micahflock/Firewatch/docs/hardware.md

# Hardware: survey, recommendation, parts list, wiring

## What the job actually needs

- **Wi-Fi.** The controller has to talk to the Roku (ECP) and serve a small web page. This rules out plain MCUs.
- **Glitch-free LED timing while Wi-Fi is busy.** The LED bitstream should come from DMA hardware, not CPU bit-banging.
- **Good low-brightness color.** A fire glow in a dark room lives in the bottom 10–30% of an LED's range, where 8-bit channels show visible steps.
- **Warm color quality.** The light falls on brick, the mantel, and the room, so it should look like firelight, not like "RGB orange".
- **About 1.5 m of strip.** It runs up the left side, across the top and down the right side of the TV's back, about 20 mm in from the edges (the TV is 731 × 437 mm), with none along the bottom. At 75 LEDs (3 dark lead-in + 72 lit), voltage drop is a non-issue at 5 V, and feeding power at the start alone is enough.

The light doesn't need to be dotless or high-density. The strip faces the firebox walls, not the viewer, so all you see is diffuse reflection.

## Controller options

| Option | Strengths | Weaknesses | Verdict |
|---|---|---|---|
| **QuinLED Dig-Uno v3 (classic ESP32 on a LED carrier board)** | The same classic ESP32 as below, plus a level shifter, 10 A fuse, bulk capacitors, screw terminals, USB-C and a 5–24 V input on one board. No soldering, and no parts packs to buy. | $27.50–37.50 + shipping from a small shop; needs its own mount (provided) | **Chosen** |
| ESP32 dev board (classic, WROOM-32E DevKitC) + DIY perfboard | Same chip and firmware; cheapest *if you already have a parts bin* (≈$16 in parts) | You solder a level shifter, fuse, terminals and diode yourself; buying all those parts in packs from scratch costs more than a Dig-Uno | Good if you have parts on hand |
| ESP32-S3 | Native USB, more RAM, PSRAM variants | No benefit for 75 LEDs; the parallel-I2S LED drivers are younger on the S3 | Fine, not better |
| ESP32-C3 / C6 | Tiny and cheap | Single core shared with Wi-Fi; fewer RMT channels; C6 LED support is still young | Workable, not ideal |
| Raspberry Pi Pico 2 W | PIO gives perfect LED timing | HTTP, mDNS and OTA are less polished under Arduino; no real advantage here | No |
| Other ready-made ESP32 LED boxes (Gledopto, Athom "WLED" controllers) | Cased, cheap | Pinouts vary by vendor, less documented; not all expose USB for flashing | Workable; set `LED_PIN` |
| Raspberry Pi Zero 2 W | Could also drive a screen | Overkill, SD card wear, 30 s boot, no real-time I/O | No |

## LED strip options

| Strip | Supply | Color | Strengths | Weaknesses |
|---|---|---|---|---|
| WS2812B | 5 V | RGB, 8-bit | Cheap and everywhere | "Warm" is mixed from narrow red and green peaks, which looks synthetic on brick and wood. Steps at low brightness. |
| **SK6812 RGBW, warm-white (≈3000 K)** | 5 V | RGB + W, 8-bit | The white die is phosphor-converted and broad-spectrum, so the glow's body looks like real warm light. RGB adds the red and orange flicker on top. Same one-wire protocol and libraries as WS2812B. Better lumens per watt for warm tones. | Slightly pricier. W is also 8-bit (the firmware dithers). |
| WS2815 | 12 V | RGB | Backup data line, lower current | Needs a buck converter for the ESP32; RGB only; 12 V is pointless at 1.5 m |
| APA102 / SK9822 | 5 V | RGB + 5-bit global | Fast PWM; the 5-bit global brightness helps low end | Four wires, pricier, still RGB-only color |
| HD108 | 5 V | 16-bit RGB | Excellent dimming | Niche, expensive, young library support |
| COB/FCOB addressable (WS2811, 12/24 V) | 12/24 V | RGB, coarse segments | Dotless | Dots are invisible here anyway (the light is reflected); coarse addressing |

## Recommendation

**QuinLED Dig-Uno v3 (pre-assembled, with QuinLED-ESP32) + SK6812 RGBW warm-white, 5 V, 60 LED/m, 10 mm, IP30 + a 5 V 3–4 A supply**, in a printed enclosure screwed to the TV's VESA holes. The wiring uses the Dig-Uno's screw terminals and a few soldered joints, so the only wire you buy is one roll of 22 AWG 3-conductor.

Why this combination:
- **RGBW warm-white is the biggest quality lever.** Real firelight is broadband, and a phosphor white die gets much closer to it than any RGB mix. On the fitted strip, though, the white die outshines the red one, and a glow built on it read as pale peach-white on the brick. The fire palette ([`fire.cpp`](../firmware/lib/firecore/src/fire.cpp)) therefore builds the glow from red and green, and adds W only to flares.
- **Low-brightness steps are handled in software.** Colors are computed in 16-bit and temporally dithered to 8-bit at 120 fps. That's cheaper and simpler than moving to 16-bit or SPI LEDs.
- **The Dig-Uno is a classic ESP32** (the lowest-risk platform for Wi-Fi plus LEDs) with the support circuitry already built: level shifter, fuse, capacitors, terminals. If you're buying everything from scratch, it costs less than the packs of parts you'd need to build that yourself, and it removes the usual failure points: grounding, the level shifter, and power wiring.
- **60 LED/m over 30/m:** more headroom and a smoother glow for a few dollars more.
- **IP30 (uncoated):** silicone-coated strips trap heat, yellow over time, and hold adhesive worse. There's no moisture in a firebox that isn't burning.

**Dig-Uno facts this design relies on** (from QuinLED's [pinout guide](https://quinled.info/quinled-dig-uno-pinout-guide/) and [dimension drawing](https://quinled.info/2020/08/02/quinled-dig-uno-board-dimensions/)):

| | |
|---|---|
| PCB | 48.52 × 39.37 mm, 4× M2 holes on a 43.27 × 34.02 mm rectangle, 26 mm from the PCB underside to the tallest part with the ESP32 fitted (measured; the enclosure leaves 2 mm above that) |
| LED data | **LED1 terminal = GPIO16** (`LED_PIN`). A jumper can move it to GPIO1; leave it on GPIO16, because GPIO1 is the serial TX pin. |
| Button | GPIO0 (`BUTTON_PIN`) |
| Spare GPIO | Q1 = GPIO15, Q2 = GPIO12 on the Q1/Q2 header (5V, GND, 3V3, Q2, Q1). Q3/Q4 = GPIO2/32. |
| Power | 5–24 V in, 10 A ATO fuse fitted, 15 A continuous |

## Shopping list (from scratch)

This keeps the number of separate purchases small. It assumes you already have a soldering iron, solder, a multimeter, a wire stripper and flush cutters. Rough 2026 US prices; where a part only comes in packs, the price is for the pack.

| # | Part | Qty used | What to buy | ≈ $ |
|---|---|---|---|---|
| 1 | **QuinLED Dig-Uno v3, pre-assembled, with QuinLED-ESP32, onboard antenna** | 1 | [quinled.info](https://quinled.info/pre-assembled-quinled-dig-uno/) or a listed distributor | 27.50–37.50 + shipping |
| 2 | **SK6812 RGBW, warm white (≈3000 K), 5 V, 60 LED/m, 10 mm, IP30** (e.g. BTF-LIGHTING) | 1.25 m (75 LEDs) | 2 m reel, leaving spare LEDs for mistakes | 20 |
| 3 | **5 V DC supply, 3–4 A, 5.5 × 2.1 mm center-positive plug**: Mean Well GST25A05-P1J (4 A, the most proven for 24/7 use) or BTF-LIGHTING 5 V 3 A adapter | 1 | Check the unit carries a UL/ETL mark. Some BTF adapters include a female barrel-to-screw-terminal adapter, which replaces item 4. | 13–15 |
| 4 | Female 5.5 × 2.1 mm DC barrel jack pigtail (pre-wired, ~15–20 cm leads) | 1 | Pack of 5–10. Its leads go into the Dig-Uno's power input, so the supply unplugs at the jack. | 7 |
| 5 | 22 AWG 3-conductor LED wire | ~1 m | 5 m roll. It's used for every connection: the run to the strip start and the two corner bridges. | 8 |
| 6 | Heat-shrink tubing | a few pieces | Small assortment | 7 |
| 7 | M4 × 12 mm pan-head screws | 4 | Small pack (VESA) | 6 |
| 8 | M2 × 8 mm self-tapping pan-head screws | 8 | Pack. They hold the board (4) and the lid (4). | 7 |
| 9 | 3M VHB tape, 12 mm (e.g. 5952) | ~0.5 m | Roll | 12 |
| 10 | Cable ties (≤ 3.6 mm wide) | a few | Pack | 4 |
| 11 | Printed parts: `firewatch_base.stl`, `firewatch_lid.stl`, 14 × `strip_clip_base_10mm.stl` + 14 × `strip_clip_cap_10mm.stl` | | PETG, about 80 g | — |
| | **Total** | | | **≈ $115–125 + Dig-Uno shipping** |

**What got cut, and why:**
- **Wago connectors:** solder joints under heat-shrink do the same job.
- **18 AWG wire:** at under 3 A over less than a metre, 22 AWG drops under 0.2 V.
- **Washers:** the M4 pan heads are wider than the 4.5 mm slots.
- **Adhesive cable clips:** leftover VHB holds the wire runs down.

**Optional IR blaster.** Only needed if you can't use Fast TV start; see [feasibility](feasibility.md#3-ir-blaster-fallback).

| Part | Qty | Notes |
|---|---|---|
| 940 nm IR LED (e.g. Vishay TSAL6200) | 1 | Aim it at the IR window on the TV's front bottom edge |
| PN2222A NPN transistor | 1 | |
| 1 kΩ (base) and 33 Ω (LED) resistors | 1 each | About 100 mA pulses from 5 V |
| Female-female Dupont jumper wires | 3 | Cut one end off. They plug onto the Q1/Q2 header, and the spare 22 AWG wire carries the run to the LED. |

## Wiring

```
 GST25A05 ──plug──► female barrel pigtail ──► Dig-Uno power input  (+ / −)
                    (cable-tied to the anchor beside the box)

 Dig-Uno LED output terminal
     5V   ─── 22AWG ──┐                  ┌──►  strip START  +5V pad
     LED1 ─── 22AWG ──┼─ JST-SM 3-pin ───┼──►  strip START  DIN pad
                      │ (unplug here)    │     (GPIO16, level-shifted)
     LED2     (unused)
     GND  ─── 22AWG ──┘                  └──►  strip START  GND pad

 Strip START = bottom of the left side (front view); strip END = bottom of the right side.

 Optional IR (Q1/Q2 header):  Q1 (GPIO15) ─[1k]─ PN2222 base; emitter → GND;
     collector → IR LED cathode; IR LED anode ─[33Ω]─ 5V.   Then set IR_LED_PIN 15.
```

Notes:
- **Supply polarity.** Pigtail lead colors aren't guaranteed. Plug the supply in, check which lead is + with a multimeter (leads apart), and unplug it again before landing them in the terminal.
- **Strain relief.** Cable-tie the pigtail's jack to one of the power-side anchors, so unplugging the supply pulls on the anchor, not the screw terminal.
- **One feed is enough.** QuinLED's guidance is that a 5 V strip of up to about 90 LEDs can be fed from one end, and this one is 75, drawing about 1–1.6 A. The far end is at the opposite bottom corner, so skipping a second feed also saves a wire across the TV. Don't tin the wire ends that go into the screw terminals; tinned wire loosens over time.
- **Strip connector.** BTF reels come with a JST-SM 3-pin plug on each end, and the two plugs mate. Keep the plug on the strip's **start** end (data arrows pointing away from it). Cut the other plug off the reel's far end with its pigtail, extend its three wires with the 22 AWG run (solder + heat-shrink), and land them in the Dig-Uno's LED output. The strip then unplugs from the controller at the connector. Match wires by what they connect to, not by color: follow each pigtail wire to the `+5V`, `Din` and `GND` pads, or check with a multimeter. Trim or heat-shrink any loose extra power leads, and cover the far end's bare pads.
- **Common ground** is automatic: everything shares the supply's GND at the Dig-Uno.
- **Don't cut strip power when "off".** An unpowered strip gets back-powered through its data line. Idle draw is about 1 mA per LED (≈0.6 W) plus about 0.5 W for the ESP32.
- **Flash over USB-C with the supply unplugged.** After the first flash, updates go over Wi-Fi.

## Power budget

| | Current (5 V) |
|---|---|
| Theoretical max: 72 lit LEDs × 4 channels × ~15 mA | 4.3 A (never reached) |
| Firmware cap (`POWER_BUDGET_MA`), including the ESP32 | 2.5 A |
| Fire at 30% brightness (default), firmware estimate over 100 s, all-in | avg 0.6 A, peak 0.7 A |
| Fire at 100% brightness | avg 1.4 A, peak 1.6 A |
| Off (ESP32 on Wi-Fi + strip idle) | ≈ 0.2 A (≈ 1.1 W) |

The web page shows the firmware's live current estimate (`ledCurrentMa`). The Dig-Uno's 10 A fuse and 15 A rating leave plenty of margin, and a 3 A supply still has about 1.4 A to spare even at full brightness.

## Mounting

The back of the TV with Firewatch fitted

*As built, seen from behind: the enclosure on the VESA holes and the strip on clips up both sides and across the top. The supply plugs in at the barrel jack on the left, and the strip at the JST plug on the right, near where it starts.*

Assembly

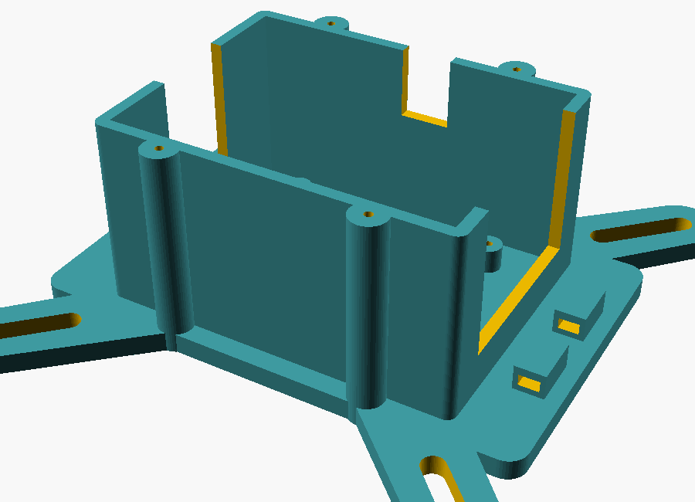
[picture p9: docs/img/base.png]
Base
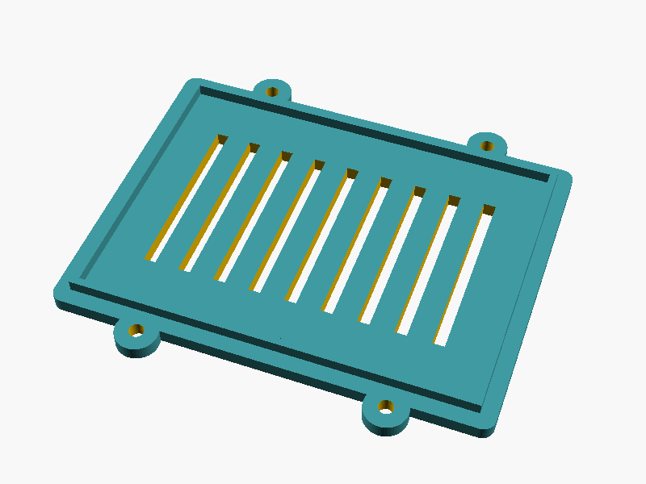
[picture p10: docs/img/lid.png]
Lid
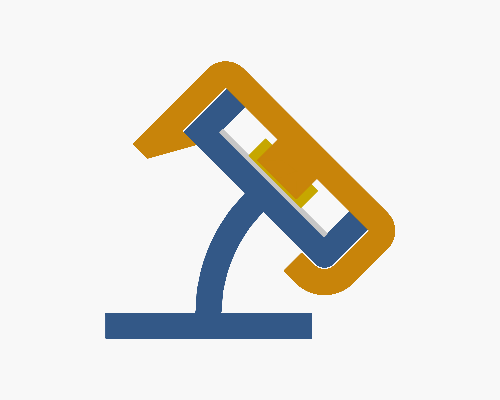
[picture p11: docs/img/clip.png]
Strip clip, end view, with the strip on the seat under the cap
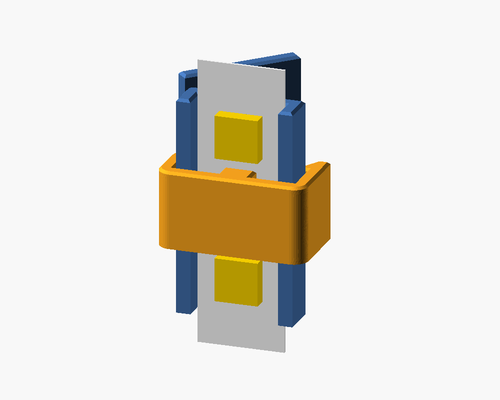
[picture p12: docs/img/clip_3d.png]
Strip clip with the cap between two LEDs
   

Sources: [`hardware/mount/firewatch_mount.scad`](../hardware/mount/firewatch_mount.scad) for the base and lid (parametric OpenSCAD, with the Dig-Uno dimensions from QuinLED's drawing), and [`hardware/mount/strip_clip_10mm.step`](../hardware/mount/strip_clip_10mm.step) for the strip clip (designed in Fusion 360; the STEP opens in any CAD program for changes). STLs are in [`hardware/mount/stl/`](../hardware/mount/stl).

| File | What | Print |
|---|---|---|
| `firewatch_base.stl` | X-shaped VESA plate + Dig-Uno enclosure. The diagonal slots fit **both 75 × 75 and 100 × 100** (the 32S335 is 100 × 100, M4). Four M2 standoffs on the Dig-Uno's hole pattern. A wide window on the power end for the barrel-jack pigtail's leads **and USB-C access**, a notch on the LED end for the strip wiring, a small notch for the optional IR lead, and three cable-tie anchors. | Flat side down, 20% infill, no supports. Load-bearing walls are 1.67 mm, locating walls (the lid lip) 0.86 mm, and the plate is 2 mm (`strong_wall`, `light_wall`, `plate_t` in the source). |
| `firewatch_base_M6.stl` | Same, with M6 clearance slots for other TVs | |
| `firewatch_lid.stl` | Vented lid with a locating lip; four M2 screws | Flat (outer) face down, no supports |
| `strip_clip_base_10mm.stl` + `strip_clip_cap_10mm.stl` | Two-part 45° strip clip for 10 mm strip. The 25 mm base sticks to the TV on a thin sole, and a curved arm carries a seat that holds the strip facing outward and backward toward the firebox walls. The strip lies in a shallow channel on the seat, so it never has to bend across its width. The 9 mm cap wraps over the seat **between two LEDs** and holds the strip down. | Both **chamfered end face down** (as exported), no supports, so elephant's foot from the first layers lands in the chamfer instead of fouling the snap fit. 14 of each. |

The Dig-Uno fits with its power terminal and USB-C toward the window end and its LED output toward the notch end. The standoffs only fit that way round, or rotated 180°.

**Installing the base:** use M4 × 12 pan-head screws through the 2 mm plate, which gives about 10 mm of thread engagement. Turn each screw in by hand first: if one stops before the head seats, it's bottoming out in the insert, so use an M4 × 10 (or add a washer) rather than forcing it. The slots near the 75 mm positions sit close to the box walls, so use a screwdriver with a shaft of at least 75 mm. The 100 mm positions have plenty of clearance.

**Wi-Fi:** the board sits between the TV's metal chassis and the brick. Check the signal (`rssi` on the status page, in dBm). If it's worse than about −75, QuinLED sells an external-antenna version of the ESP32 board, and its lead can leave through the power window.

**Strip placement:** put clips about 20 mm in from the TV's outer edge, up the left side, across the top and down the right side (none along the bottom). Space them every ~15 cm, plus one on each side of the two top corners (about 12–14 in total), with the seat facing outward. **At the two top corners, bend the strip around in one piece** (the as-built choice). It saves four solder joints, at the cost of some stress on the flexible PCB and roughly one LED of length per corner. Alternatively, cut at the copper cut marks and bridge the three pads with short lengths of the 22 AWG 3-conductor wire, soldered on the bench before fitting. The first 3 LEDs of the strip serve as a dark lead-in that carries the plug end out to where the left run starts (`LED_LEAD_IN`). Clean the TV back with isopropyl alcohol before applying the VHB, and press for 30 s. If your per-side LED counts differ from 17/38/17, put them in `kLedLayout`.

A side run of the strip on its clips

*A side run: each clip base holds the strip at 45°, facing outward, with a cap snapped on between two LEDs.*
