micahflock/Firewatch/hardware/mount/stl/strip_clip_cap_10mm.stl

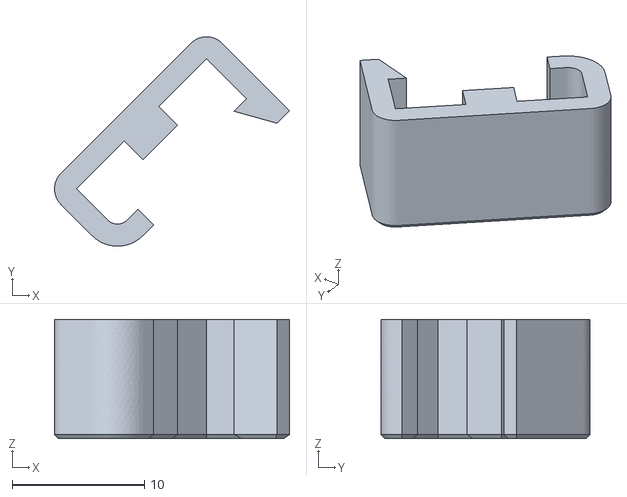
[picture p13: CAD file, 2026-10-17]
hardware/mount/stl/strip_clip_cap_10mm.stl
17.8 x 15.8 x 9.00
