micahflock/Firewatch/hardware/mount/strip_clip_10mm.step

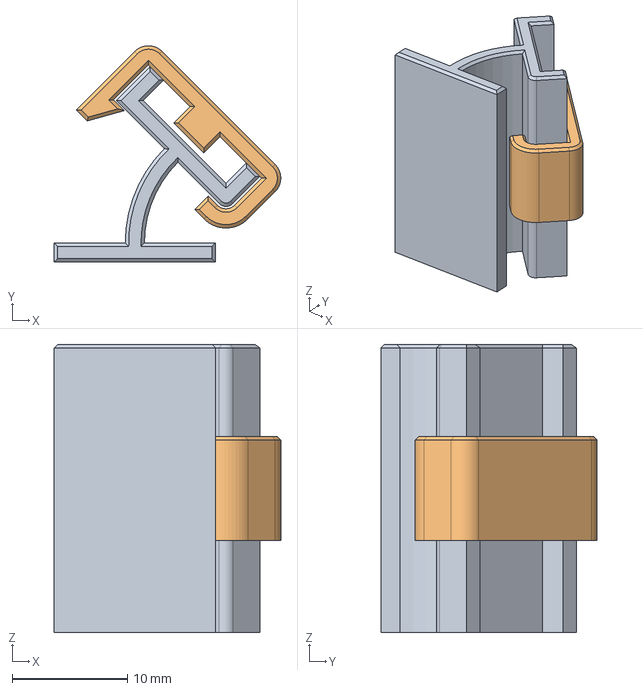
[picture p14: CAD file, 2026-10-16]
hardware/mount/strip_clip_10mm.step
19.7 x 18.8 x 25.0 mm
