micahflock/Firewatch/hardware/mount/stl/strip_clip_base_10mm.stl

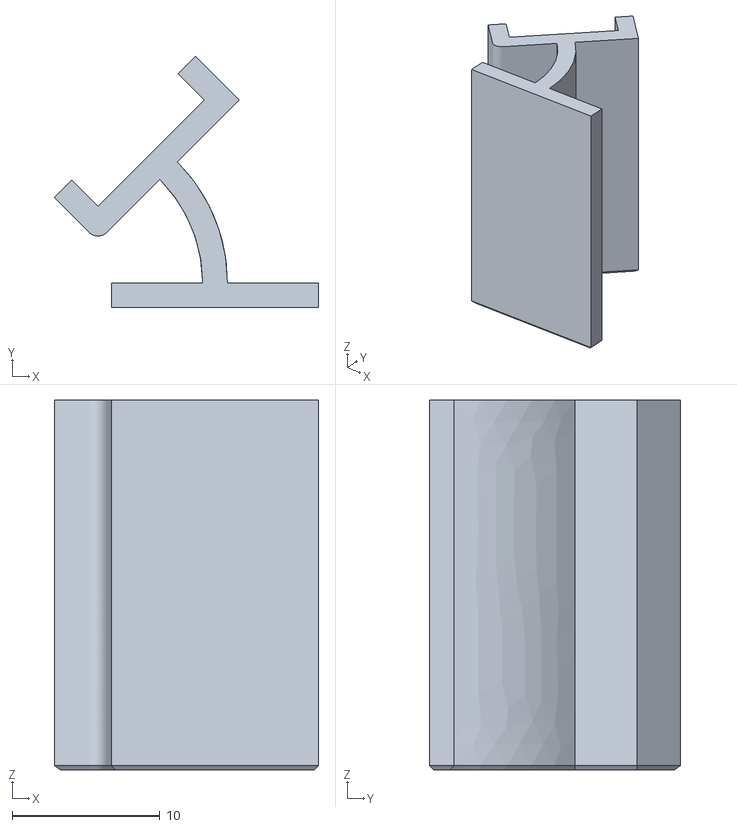
[picture p15: CAD file, 2026-10-17]
hardware/mount/stl/strip_clip_base_10mm.stl
17.9 x 17.0 x 25.0
