micahflock/Firewatch/hardware/mount/stl/firewatch_lid.stl

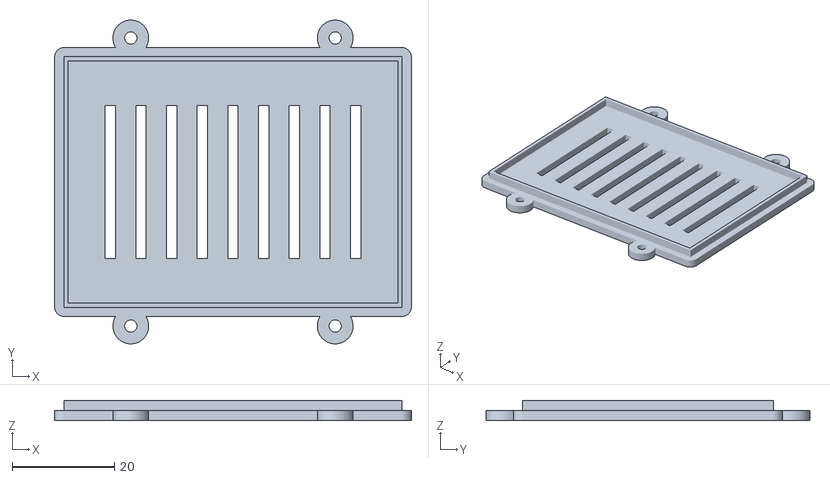
[picture p16: CAD file, 2026-10-08]
hardware/mount/stl/firewatch_lid.stl
69.9 x 63.4 x 3.99
