micahflock/Firewatch/hardware/mount/stl/firewatch_base.stl

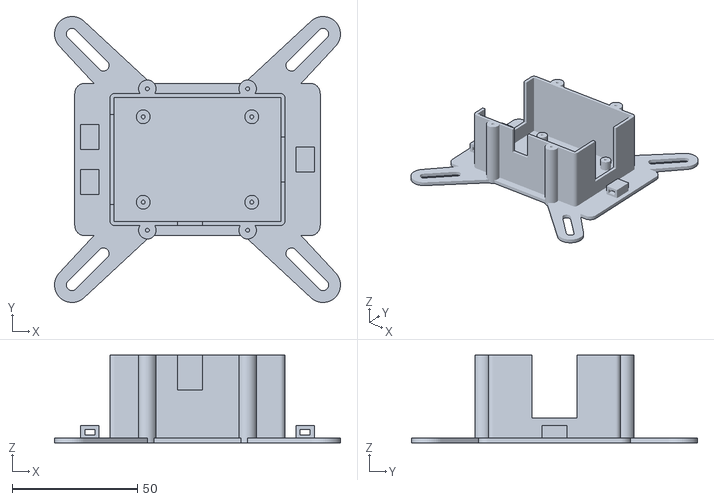
[picture p17: CAD file, 2026-10-08]
hardware/mount/stl/firewatch_base.stl
114.0 x 114.0 x 35.0
