micahflock/Firewatch/(list of files, cad)

Other CAD files:
hardware/mount/stl/firewatch_base_M6.stl
