micahflock/Firewatch/firmware/src/main.cpp

// Firewatch: fire-glow LEDs around a Roku TV, started and stopped together with the TV.
//
// Core 1 (Arduino loop): fire animation -> dithering -> LEDs at TARGET_FPS, plus button/OTA.
// Core 0: "net" task polls the TV and runs the Scene state machine; "web" task serves HTTP;
// HomeSpan's task serves Apple Home and owns Wi-Fi and mDNS. The BLE host task delivers
// lighter frames.
// The only state crossing tasks is a command queue, a few atomics, mutex-guarded status and
// the mutex-guarded fire tuning.

#include <Arduino.h>
#include <ArduinoOTA.h>
#include <ESPmDNS.h>
#include <Preferences.h>
#include <WebServer.h>
#include <WiFi.h>
#include <esp_random.h>
#include <esp_timer.h>

#include <atomic>
#include <mutex>

#include "config.h"
#include "fire.h"
#include "home_sync.h"
#include "homekit.h"
#include "ir.h"
#include "leds.h"
#include "lighter_rx.h"
#include "output.h"
#include "roku_client.h"
#include "scene.h"
#include "tuning.h"
#include "web_page.h"

#if __has_include("secrets.h")
#include "secrets.h"
#else
#warning "include/secrets.h missing - copy secrets.example.h and fill in your Wi-Fi details"
#include "secrets.example.h"
#endif
#ifndef HOMEKIT_SETUP_CODE
#define HOMEKIT_SETUP_CODE ""
#endif
#ifndef SKEUMO_LINK_KEY
#define SKEUMO_LINK_KEY ""
#endif
// HomeSpan halts the whole board at boot on a setup code it rejects.
static_assert(sizeof(HOMEKIT_SETUP_CODE) == 1 || fw::validSetupCode(HOMEKIT_SETUP_CODE),
              "HOMEKIT_SETUP_CODE in secrets.h must be 8 digits, not all the same digit, "
              "and not 12345678 or 87654321");

namespace {

QueueHandle_t commandQueue;
std::atomic<bool> lightsOn{false};
std::atomic<int> brightnessPct{DEFAULT_BRIGHTNESS};
std::atomic<float> currentMa{0};

struct Status {
  const char* state = "off";
  const char* tv = "unknown";
  String activeApp, host, model, event, error;
};
std::mutex statusMutex;
Status status;

RokuClient roku;
WebServer server(80);
Preferences prefs;
std::atomic<bool> wifiReady{false};

void setBrightness(int pct) {
  pct = constrain(pct, 0, 100);
  brightnessPct = pct;
  prefs.putUChar("bright", pct);
}

// Fire tuning from the web page. The web task edits `tuning` and bumps tuningVersion; the
// render loop copies it into the engine when it can take the lock without waiting. It is
// saved to flash once the sliders have been still for a moment, to spare the flash.
std::mutex tuningMutex;
fw::FireParams tuning;
std::atomic<uint32_t> tuningVersion{0};
uint32_t tuningChangedMs = 0;
bool tuningUnsaved = false;

String tuningPrefKey(const fw::Tunable& t) { return String("t_") + t.key; }

void loadTuning() {
  for (size_t i = 0; i < fw::kTunableCount; ++i) {
    const fw::Tunable& t = fw::kTunables[i];
    String k = tuningPrefKey(t);
    if (prefs.isKey(k.c_str())) fw::setTunable(tuning, t.key, prefs.getFloat(k.c_str()));
  }
}

// Only values that differ from the defaults are stored, so a later firmware's new defaults
// still reach the settings nobody has touched.
void saveTuning() {
  fw::FireParams p, d;
  {
    std::lock_guard<std::mutex> lock(tuningMutex);
    p = tuning;
  }
  for (size_t i = 0; i < fw::kTunableCount; ++i) {
    const fw::Tunable& t = fw::kTunables[i];
    String k = tuningPrefKey(t);
    if (p.*(t.field) == d.*(t.field)) {
      if (prefs.isKey(k.c_str())) prefs.remove(k.c_str());
    } else {
      prefs.putFloat(k.c_str(), p.*(t.field));
    }
  }
}

// Called once by HomeSpan when Wi-Fi first connects, after it has started mDNS as HOSTNAME.
void onWifiConnected() {
  Serial.printf("[wifi] connected %s\n", WiFi.localIP().toString().c_str());
  MDNS.addService("http", "tcp", 80);
  ArduinoOTA.setHostname(HOSTNAME);
  ArduinoOTA.setPassword(OTA_PASSWORD);
  ArduinoOTA.setMdnsEnabled(false);  // HomeSpan owns mDNS; register OTA with it instead
  ArduinoOTA.begin();
  MDNS.enableArduino(3232, true);
  wifiReady = true;
}

const char* stateName(fw::Scene::State s) {
  switch (s) {
    case fw::Scene::State::Off: return "off";
    case fw::Scene::State::Waking: return "waking TV";
    case fw::Scene::State::On: return "on";
  }
  return "?";
}

const char* tvName(fw::TvPower p) {
  switch (p) {
    case fw::TvPower::On: return "on";
    case fw::TvPower::Standby: return "standby";
    case fw::TvPower::Unreachable: return "unreachable";
  }
  return "?";
}

void execute(const fw::Actions& a) {
  if (a.powerOff) roku.powerOff();
  if (a.wake) roku.wake();
  if (a.launch) roku.launchFire();
}

// ---- network task: TV polling + scene policy ---------------------------------------
void netTask(void*) {
  fw::SceneTiming timing;
  timing.followTv = FOLLOW_TV;
  fw::Scene scene(timing);
  roku.begin(ROKU_HOST);
  uint32_t lastPoll = 0;
  fw::TvPower lastPower = fw::TvPower::Unreachable;

  for (;;) {
    fw::Command c;
    uint32_t interval = scene.state() == fw::Scene::State::Waking ? 1000 : POLL_INTERVAL_MS;
    uint32_t elapsed = millis() - lastPoll;
    TickType_t wait = pdMS_TO_TICKS(elapsed >= interval ? 0 : interval - elapsed);
    if (xQueueReceive(commandQueue, &c, wait) == pdTRUE) {
      fw::Actions a = scene.command(c, millis());
      lightsOn = scene.lightsOn();  // before the ECP calls, so the glow never waits on the TV
      execute(a);
    }
    if (WiFi.status() == WL_CONNECTED && millis() - lastPoll >= interval) {
      lastPoll = millis();
      fw::TvStatus s = roku.poll();
      lastPower = s.power;
      fw::Actions a = scene.observe(s, millis());
      lightsOn = scene.lightsOn();
      execute(a);
    }

    std::lock_guard<std::mutex> lock(statusMutex);
    status.state = stateName(scene.state());
    status.tv = tvName(lastPower);
    status.activeApp = roku.activeApp();
    status.host = roku.host();
    status.model = roku.model();
    status.event = scene.lastEvent();
    status.error = roku.lastError();
  }
}

// ---- Apple Home + lighter ----------------------------------------------------------------
bool lighterLinkOk = false;

void queueCommand(fw::Command c) { xQueueSend(commandQueue, &c, 0); }

void onLighter(const skeumo::link::Message& m) {
#if LIGHTER_DIRECT
  if (m.channel == LIGHTER_STRIKE_CHANNEL) queueCommand(fw::Command::On);
  if (m.channel == LIGHTER_SNUFF_CHANNEL) queueCommand(fw::Command::Off);
#endif
  homekit::lighterEvent(m);
}

// ---- web task ------------------------------------------------------------------------
void sendCommand(fw::Command c) {
  queueCommand(c);
  server.send(200, "application/json", "{\"ok\":true}");
}

String jsonEscape(const String& s) {
  String o;
  for (char ch : s) {
    if (ch == '"' || ch == '\\') o += '\\';
    if (static_cast<uint8_t>(ch) >= 0x20) o += ch;
  }
  return o;
}

void handleStatus() {
  String j = "{";
  {
    std::lock_guard<std::mutex> lock(statusMutex);
    j += "\"scene\":\"" + String(status.state) + "\",";
    j += "\"tv\":\"" + String(status.tv) + "\",";
    j += "\"activeApp\":\"" + jsonEscape(status.activeApp) + "\",";
    j += "\"rokuHost\":\"" + jsonEscape(status.host) + "\",";
    j += "\"rokuModel\":\"" + jsonEscape(status.model) + "\",";
    j += "\"lastEvent\":\"" + jsonEscape(status.event) + "\",";
    j += "\"lastError\":\"" + jsonEscape(status.error) + "\",";
  }
  j += "\"brightness\":" + String(brightnessPct.load()) + ",";
  j += "\"ledCurrentMa\":" + String(static_cast<int>(currentMa.load())) + ",";
  j += "\"videoConfigured\":" + String(sizeof(FIRE_CONTENT_ID) > 1 ? "true" : "false") + ",";
#if LIGHTER_ENABLED
  {
    lighter_rx::Stats l = lighter_rx::stats();
    j += "\"lighter\":{";
    j += "\"link\":\"" + String(lighterLinkOk ? "ok" : "no valid SKEUMO_LINK_KEY") + "\",";
    j += "\"lastSeenS\":" + (l.lastSeenMs ? String((millis() - l.lastSeenMs) / 1000) : String("null")) + ",";
    j += "\"lastChannel\":" + String(l.lastChannel) + ",";
    j += "\"battery\":" + (l.batteryPct <= 100 ? String(l.batteryPct) : String("null")) + ",";
    j += "\"rssi\":" + String(l.rssi) + ",";
    j += "\"counter\":" + String(l.counter) + ",";
    j += "\"rejected\":" + String(l.rejected) + "},";
  }
#endif
  j += "\"homekit\":\"" + String(homekit::paired() ? "paired" : "unpaired") + "\",";
  j += "\"freeHeap\":" + String(ESP.getFreeHeap()) + ",";
  j += "\"uptimeS\":" + String(millis() / 1000) + ",";
  j += "\"rssi\":" + String(WiFi.RSSI()) + "}";
  server.send(200, "application/json", j);
}

String tuningJson() {
  fw::FireParams p, d;
  {
    std::lock_guard<std::mutex> lock(tuningMutex);
    p = tuning;
  }
  String j = "{\"controls\":[";
  for (size_t i = 0; i < fw::kTunableCount; ++i) {
    const fw::Tunable& t = fw::kTunables[i];
    if (i) j += ",";
    j += "{\"key\":\"" + String(t.key) + "\",\"group\":\"" + t.group + "\",\"label\":\"" + t.label +
         "\",\"hint\":\"" + t.hint + "\",\"min\":" + String(t.min, 3) + ",\"max\":" + String(t.max, 3) +
         ",\"step\":" + String(t.step, 3) + ",\"value\":" + String(p.*(t.field), 3) +
         ",\"default\":" + String(d.*(t.field), 3) + "}";
  }
  return j + "]}";
}

// POST /tune?orange=1.4&flickTop=0.6 sets any number of controls; unknown names are ignored.
void handleTune() {
  bool changed = false;
  {
    std::lock_guard<std::mutex> lock(tuningMutex);
    for (int i = 0; i < server.args(); ++i)
      changed |= fw::setTunable(tuning, server.argName(i).c_str(), server.arg(i).toFloat());
  }
  if (changed) {
    ++tuningVersion;
    tuningChangedMs = millis();
    tuningUnsaved = true;
  }
  server.send(200, "application/json", tuningJson());
}

void handleTuneReset() {
  {
    std::lock_guard<std::mutex> lock(tuningMutex);
    tuning = fw::FireParams{};
  }
  ++tuningVersion;
  tuningUnsaved = false;
  saveTuning();
  server.send(200, "application/json", tuningJson());
}

void webTask(void*) {
  server.on("/", HTTP_GET, [] { server.send_P(200, "text/html", kIndexHtml); });
  server.on("/status", HTTP_GET, handleStatus);
  // GET is accepted too so a phone shortcut, bookmark or smart-home webhook can trigger it.
  server.on("/on", [] { sendCommand(fw::Command::On); });
  server.on("/off", [] { sendCommand(fw::Command::Off); });
  server.on("/toggle", [] { sendCommand(fw::Command::Toggle); });
  server.on("/relaunch", [] { sendCommand(fw::Command::Relaunch); });
#if LIGHTER_ENABLED
  // After erasing and re-flashing the lighter its counter restarts; accept it again.
  server.on("/lighter/reset", [] {
    lighter_rx::resetCounter();
    server.send(200, "application/json", "{\"ok\":true}");
  });
#endif
  server.on("/brightness", [] {
    if (server.hasArg("value")) setBrightness(server.arg("value").toInt());
    server.send(200, "application/json", "{\"brightness\":" + String(brightnessPct.load()) + "}");
  });
  server.on("/tune", HTTP_GET, [] { server.send(200, "application/json", tuningJson()); });
  server.on("/tune", HTTP_POST, handleTune);
  server.on("/tune/reset", HTTP_POST, handleTuneReset);
  server.begin();
  for (;;) {
    server.handleClient();
    if (tuningUnsaved && millis() - tuningChangedMs > 2000) {
      tuningUnsaved = false;
      saveTuning();
    }
    vTaskDelay(pdMS_TO_TICKS(5));
  }
}

// ---- setup / render loop (core 1) ---------------------------------------------------
std::vector<fw::LedPos> layout = fw::buildLayout(kLedLayout, sizeof(kLedLayout) / sizeof(kLedLayout[0]));
fw::FireEngine* fire;
fw::OutputStage* output;
fw::Fader fader(FADE_IN_S, FADE_OUT_S);
std::vector<fw::Rgbw> frame;
std::vector<uint8_t> wire;
uint32_t appliedTuning = 0;
int64_t lastFrameUs = 0;
bool stripDark = false;

void pollButton() {
#if BUTTON_PIN >= 0
  static bool stable = true, lastRead = true;
  static uint32_t changedAt = 0;
  bool r = digitalRead(BUTTON_PIN);
  if (r != lastRead) {
    lastRead = r;
    changedAt = millis();
  } else if (r != stable && millis() - changedAt > 30) {
    stable = r;
    if (!stable) {
      queueCommand(fw::Command::Toggle);
    }
  }
#endif
}

}  // namespace

void setup() {
  Serial.begin(115200);
  prefs.begin("firewatch", false);
  brightnessPct = prefs.getUChar("bright", DEFAULT_BRIGHTNESS);
#if BUTTON_PIN >= 0
  pinMode(BUTTON_PIN, INPUT_PULLUP);
#endif
  ir::begin();

  loadTuning();
  fire = new fw::FireEngine(layout, esp_random());
  fire->params = tuning;
  fw::OutputConfig oc;
  oc.rgbw = LED_RGBW;
  oc.maPerChannel = MA_PER_CHANNEL;
  oc.maBudget = POWER_BUDGET_MA;
  output = new fw::OutputStage(layout.size(), oc);
  frame.resize(layout.size());
  wire.resize(layout.size() * output->channels());
  leds::begin(layout.size());

  // HomeSpan (homekit::begin) connects, reconnects and starts mDNS; see onWifiConnected().
  WiFi.mode(WIFI_STA);
  WiFi.setHostname(HOSTNAME);
  WiFi.setSleep(false);  // modem sleep adds latency and drops SSDP replies

  commandQueue = xQueueCreate(8, sizeof(fw::Command));
  xTaskCreatePinnedToCore(netTask, "net", 8192, nullptr, 1, nullptr, 0);
  xTaskCreatePinnedToCore(webTask, "web", 6144, nullptr, 1, nullptr, 0);

  homekit::Hooks hooks;
  hooks.setFire = [](bool on) { queueCommand(on ? fw::Command::On : fw::Command::Off); };
  hooks.fireOn = [] { return lightsOn.load(); };
  hooks.setBrightness = setBrightness;
  hooks.brightness = [] { return brightnessPct.load(); };
  hooks.onWifiConnected = onWifiConnected;
  homekit::begin(hooks, WIFI_SSID, WIFI_PASSWORD, HOMEKIT_SETUP_CODE);

#if LIGHTER_ENABLED
  skeumo::link::Key key;
  lighterLinkOk = skeumo::link::parseKey(SKEUMO_LINK_KEY, key);
  if (lighterLinkOk) {
    lighter_rx::begin(key, LIGHTER_DEVICE_ID, onLighter);
  } else {
    Serial.println("[lighter] SKEUMO_LINK_KEY missing or malformed in secrets.h; not listening");
  }
#endif
  lastFrameUs = esp_timer_get_time();
}

void loop() {
  if (wifiReady) ArduinoOTA.handle();
  pollButton();

  const int64_t now = esp_timer_get_time();
  const int64_t frameUs = 1000000 / TARGET_FPS;
  if (now - lastFrameUs < frameUs || !leds::ready()) {
    delay(1);
    return;
  }
  float dt = (now - lastFrameUs) / 1e6f;
  lastFrameUs = now;

  fader.setTarget(lightsOn.load());
  float env = fader.step(dt);
  if (fader.idle()) {
    if (!stripDark) {
      std::fill(wire.begin(), wire.end(), 0);
      leds::show(wire.data());
      stripDark = true;
      currentMa = 0;
    }
    return;
  }
  stripDark = false;
  if (tuningVersion.load() != appliedTuning) {
    std::unique_lock<std::mutex> lock(tuningMutex, std::try_to_lock);
    if (lock.owns_lock()) {
      appliedTuning = tuningVersion.load();
      fire->params = tuning;
    }
  }
  fire->render(now / 1e6, frame.data());
  output->process(frame.data(), env * brightnessPct.load() / 100.0f, wire.data());
  currentMa = output->currentMa();
  leds::show(wire.data());
}
