micahflock/Firewatch/(commit log)

2026-09-25 Add Firewatch: fire-glow LEDs + Roku scene control for a fireplace TV
    - Feasibility study: smart-plug-only rejected (Roku TVs don't resume apps
    after power loss); Roku ECP for wake/launch; follow-the-TV power so the
    Roku remote is the single action; IR as a wake-only fallback.
    - Hardware survey and recommendation (ESP32 DevKitC + SK6812 RGBW
    warm-white), parts list, wiring, power budget.
    - Parametric OpenSCAD VESA enclosure (75/100 slots), lid and 45-degree
    strip clips, exported as STLs.
    - ESP32 firmware: noise-based firelight engine with 16->8-bit temporal
    dithering and current limiting, I2S DMA output, ECP client with SSDP
    discovery and Wake-on-LAN, scene state machine, web UI/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
    [firewatch_base.stl, firewatch_base_M6.stl, firewatch_lid.stl, firewatch_mount.scad, strip_clip_10mm.stl, strip_clip_12mm.stl]
2026-09-25 Switch controller to QuinLED Dig-Uno; set fireplace video
    - Enclosure redesigned around the Dig-Uno v3 (48.52 x 39.37 mm PCB,
    M2 holes on 43.27 x 34.02 mm, from QuinLED's drawing): M2 standoffs,
    power/USB-C window, LED-out notch, IR notch, cable-tie anchors.
    - Hardware doc: Dig-Uno recommendation, from-scratch shopping list
    priced by pack, solderless wiring (screw terminals + Wagos, folded
    strip corners), Dig-Uno pin facts.
    - Install doc: WLED bench test before flashing, Dig-Uno assembly steps.
    - Firmware: document Dig-Uno pins (LED1=GPIO16, button=GPIO0, IR on
    Q1=GPIO15), refuse LED_PIN 1 (serial TX), set FIRE_CONTENT_ID to
    CF00JqnCcsU.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
    [firewatch_base.stl, firewatch_base_M6.stl, firewatch_lid.stl, firewatch_mount.scad]
2026-09-25 Revise shopping list for a soldered build with fewer purchases
    Drop Wago connectors, the barrel-jack adapter, 18 AWG wire, washers and
    adhesive cable clips. The supply cord goes straight into the Dig-Uno,
    both strip feeds come from its LED output terminal, and all strip
    joints (start, end, corner bridges) are soldered with one roll of
    22 AWG 3-conductor wire and heat-shrink. Install steps, wiring diagram
    and README updated to match.
    Claude-Session: https://claude.ai/code/session_01PAB8hDfJJakCg9CnFihqAr
    [firewatch_mount.scad]
2026-09-25 Add back a barrel connector so the supply unplugs easily
    A pre-wired female 5.5x2.1 mm pigtail lands in the Dig-Uno's power
    input and is cable-tied to a power-side anchor for strain relief; the
    Mean Well supply keeps its plug. Shopping list, wiring diagram, install
    steps and README updated.
    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
    [firewatch_mount.scad]
2026-09-25 Match the fire engine to the chosen fireplace video
    - tools/video_match: measure a YouTube video's light from its public
    storyboard frames (zone variability, correlations, balance, color,
    repeat structure) and fit FireParams to it via the preview binary.
    - Engine: flicker amplitude now grows with height (flickerBottom /
    flickerTop), breath separated from flicker; defaults refitted to
    CF00JqnCcsU (steady ember bed, lively top, independent sides, smaller
    flares); palette moved from red-orange to amber, built from R+G with
    warm white as support.
    - Preview: parameter overrides, optional frames on the TV, lower
    simulated exposure; regenerated GIF.
    - Feasibility section 5: statistica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
2026-09-25 Remove stray preview check frames
    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
2026-09-25 Drop the bottom LED edge: strip runs up the sides and across the top
    - Layout is now 23/41/23 (87 LEDs), starting at the bottom of the left
    side and ending at the bottom of the right side; single power feed.
    - Video match: zones redefined for the U shape (lower thirds of the
    sides as the steady reference, video total measured over the same
    edge region); refitted defaults (even brightness around the U,
    steady low sides, lively top).
    - Tests, preview, power figures (avg ~1.0 A at default brightness),
    shopping list (2 m reel, 14 clips, ~$115-125), wiring and install
    steps updated.
    Claude-Session: https://claude.ai/code/session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
2026-09-25 Set the TV's static IP and Wi-Fi MAC; note the 2.4 GHz requirement
    ROKU_HOST is now 192.168.1.176. ROKU_WIFI_MAC seeds Wake-on-LAN before
    the firmware has read the MAC from the TV, and a later device-info
    read without a MAC no longer clears a known one. Install guide notes
    the ESP32 needs a 2.4 GHz network on the same LAN.
    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
    [config.h, roku_client.cpp]
2026-09-25 Record ECP playback-position result; make curl checks Windows-friendly
    YouTube on the TCL reports <position> via query/media-player (no
    <duration>), and resumes mid-video on launch. Level 2 now hinges on
    position granularity; add a PowerShell sampling test. Install checks
    use -d "" and note findstr/curl.exe for Windows.
    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
2026-09-26 Pass the OTA password to espota uploads
    The esp32-ota environment never sent --auth, so Wi-Fi updates would be
    rejected by the board. Read it from FIREWATCH_OTA_PASSWORD so it stays
    out of committed files; document the one-time setx.
    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
2026-09-26 Keep the strip's JST-SM plug as a controller disconnect
    Wire the reel's spare mating plug to the Dig-Uno instead of cutting
    the start plug off, so the strip unplugs at the controller. Note to
    match pigtail wires by pad, not color.
    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
2026-09-26 Allow a 5 V 3 A supply; lower the firmware current cap to 2.5 A
    The fire peaks around 1.6 A, so a 3 A adapter (e.g. BTF-LIGHTING)
    works; 2.5 A keeps headroom on it and never limits the glow.
    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
2026-09-28 Add Apple Home (HomeSpan) and the Skeumo fireplace lighter
    Firewatch now appears in Apple Home as a bridge:
    - "Fireplace": a switch that mirrors the scene however it was started;
    turning it on/off from Home, Siri, scenes or automations runs /on and /off.
    - "Lighter": Strike and Snuff stateless buttons plus battery level, fed by a
    passive BLE scan for the lighter's signed frames (skeumo_link, vendored
    from the Skeumo repo). With LIGHTER_DIRECT, a strike/snuff also drives the
    scene directly, without a round trip through the Home hub.
    The glow now follows the scene before the ECP calls run, so it no longer
    waits on the TV's HTTP responses. Partition table moves to min_spiffs to fit
    Hom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
    [config.h, homekit.cpp, homekit.h, lighter_rx.cpp, lighter_rx.h, main.cpp, secrets.example.h]
2026-10-08 Shorten the enclosure to the Dig-Uno's measured 26 mm height
    The base assumed 30 mm from the PCB underside to the tallest part, from
    QuinLED's published figure. The fitted board measures 26 mm, so the walls
    come down 4 mm (37 mm overall, 28 mm above the standoffs, still 2 mm of
    headroom). The lid and footprint are unchanged.
    Claude-Session: https://claude.ai/code/session_01FWBHKAvQwrdACpqzJmb8BV
    [firewatch_base.stl, firewatch_base_M6.stl, firewatch_mount.scad]
2026-10-08 Print-tune the mount: 1.67 mm thin walls, 2 mm floors
    - New thin_wall = 1.67 mm drives the box walls, the lid's locating lip,
    the cable-tie anchors' side walls, and every thickness in the strip
    clip's profile (it prints profile face down, so all of them are
    vertical walls).
    - VESA plate and lid are 2 mm thick (were 4 and 2.4). The base drops to
    35 mm overall; the board sits at the same height above the plate.
    - The standoff pilot holes are clamped so they stop 0.4 mm short of the
    thinner floor instead of breaking through.
    - Docs: M4 x 12 now engages about 10 mm; use M4 x 10 if one bottoms out.
    Claude-Session: https://claude.a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
    [firewatch_base.stl, firewatch_base_M6.stl, firewatch_lid.stl, firewatch_mount.scad, strip_clip_10mm.stl, strip_clip_12mm.stl]
2026-10-08 Use 0.86 mm for walls that only locate or guide
    Split the wall thickness in two: strong_wall (1.67 mm) for the box walls,
    the cable-tie anchors and the clip's VHB mounting sole; light_wall
    (0.86 mm) for the lid's locating lip and the strip clip's channel walls,
    floor and retaining lips. Regenerated the lid and both clips; the base
    geometry is unchanged.
    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
    [firewatch_lid.stl, firewatch_mount.scad, strip_clip_10mm.stl, strip_clip_12mm.stl]
2026-10-08 Split the strip clip into a seat base and a snap-on cap
    The one-piece clip needed the strip bowed across its width to get the
    PCB edges under the retaining lips, which a strip won't do. Now the base
    has a flat seat the strip just lies on, and a 5 mm cap snaps over the
    seat between two LEDs: hooks catch under the seat's edges, lips press
    the PCB edges down, and 1 mm of headroom clears the capacitor between
    them. The cap's top flexes to let the hooks spread.
    - New parts clip_base and clip_cap (plus a clip_assembly preview with a
    strip ghost); STLs strip_clip_{base,cap}_{10,12}mm replace
    strip_clip_{10,12}mm.
    - Re-rendered the assembly and clip images; added a 3D clip view.
    - Updated the p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
    [firewatch_mount.scad, strip_clip_10mm.stl, strip_clip_12mm.stl, strip_clip_base_10mm.stl, strip_clip_base_12mm.stl, strip_clip_cap_10mm.stl, strip_clip_cap_12mm.stl]
2026-10-10 HomeSync: don't drop a quick reversing Home tap
    While a Home write is still being carried out, compare the next write
    against what Home asked for, not the device's not-yet-updated state.
    Found in final review.
2026-10-10 Apple Home: dimmable Fireplace light kept in sync by HomeSync
    - Fireplace becomes a LightBulb with Brightness (shared with the web
    slider). HomeSync decides when a Home write is a scene command: a write
    that matches the current state no longer relaunches the fire over what
    the TV is playing, and a quick undo tap is no longer dropped.
    - HomeSpan owns Wi-Fi and mDNS; HTTP and OTA register from its Wi-Fi
    callback (the arrangement verified on the hardware).
    - /status reports HomeKit pairing; a rejected setup code fails the build
    instead of halting the board.
    - OTA reads the password from secrets.h and resolves firewatch.local with
    retries; no more FIREWATCH_OTA_PASSWORD environment v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
    [config.h, homekit.cpp, homekit.h, main.cpp, ota_auth.py, secrets.example.h]
2026-10-10 OTA: retry the firewatch.local lookup for up to ~15 s
    A cold lookup on Windows missed five times in a row.
    [ota_auth.py]
2026-10-11 Renumber LEDs for the as-fitted strip: 3 dark lead-in, then 17/38/17
    The strip bends around the top corners instead of being cut, and its first
    3 LEDs extend the plug end, so they stay dark (new LED_LEAD_IN setting).
    Claude-Session: https://claude.ai/code/session_019vU3ZaZ2J37JNMEbfHLPkZ
2026-10-12 Let the glow dip and go dark; default brightness 30%
    The glow only changed color, so it read as constant light. A separate
    brightness layer now fades patches down and back over a few seconds:
    across the top they go fully dark about a tenth of the time, while the
    lower sides (the ember bed) only dim, by about +/-17%. Overall light is
    roughly halved, and the default brightness drops from 80 to 30.
    New FireParams dim* settings are exposed in tools/preview, with a test
    that the flame tips go dark sometimes and the ember bed never does.
    Docs, power table and the README preview are updated.
    Claude-Session: https://claude.ai/code/session_01R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
2026-10-12 Revert "Let the glow dip and go dark; default brightness 30%"
    This reverts commit 6133a07. On the strip the dips looked worse than the
    steady red-orange glow, so the fire engine, default brightness (back to
    80), docs and README preview return to the previous version.
    Claude-Session: https://claude.ai/code/session_01RXT4T4qfZZ1d6ZZxJgGTVD
    [config.h]
2026-10-12 Add live glow tuning to the firewatch.local page
    A "Tune the glow" panel on the web page adjusts the fire while it runs:
    color mix (red, orange, warm white), highs and lows (glow level and
    flicker depth for the lower sides and the top), and motion (speed,
    flare interval and strength). Changes reach the strip on the next frame
    and are saved to flash two seconds after the last change; only values
    that differ from the defaults are stored. "Show settings" lists them as
    key=value lines that tools/preview also accepts.
    The tunables live in a table in firecore (tuning.h/.cpp), which drives
    the page's sliders, GET/POST /tune and /tune/reset, and is host-tested.
    FireParams gains color gains and a sp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
    [main.cpp]
2026-10-16 Add a video of the install to the README
    The GIF plays inline and links to the MP4. Both were re-encoded from the
    phone's HDR clip to SDR H.264 with all metadata (location, device, dates)
    stripped.
    Claude-Session: https://claude.ai/code/session_01LXXcyr2doHZrfUAD1bsGj8
2026-10-16 Add assembly photos to the docs
    The finished back goes in the README and hardware.md, a side run of
    clips beside the strip placement notes, and the open enclosure and a
    top corner at their build steps in install.md. EXIF is stripped and
    the TV's serial-number label is blurred.
    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
2026-10-16 Rewrite the README as a fuller project overview
    Adds highlights, the scene behaviour as a table, a section on how the
    glow was fitted to the video, a screenshot of the firewatch.local page
    (rendered from the real page with mock device data), and the build
    photos next to a hardware summary. Drops the one-off note about the
    partition-table change, which install.md already covers.
    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
2026-10-16 Relicense as copyleft open source: GPL-3.0, CERN-OHL-S-2.0, CC BY-SA 4.0
    Replaces CC BY-NC 4.0. Firmware and tools are GPL-3.0-or-later, the
    mount designs CERN-OHL-S-2.0, and docs and media CC BY-SA 4.0. LICENSE
    maps each path to its license and says what each asks of people who
    distribute the work; the full texts are in LICENSES/. The mount's
    OpenSCAD source carries an SPDX identifier and source location, as
    CERN-OHL-S asks.
    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
    [firewatch_mount.scad]
2026-10-16 Replace the strip clip with the updated Fusion 360 design
    The new two-part clip (25 mm base with a curved arm up to a 45-degree
    seat, 9 mm wrap-over cap) comes as a STEP file,
    hardware/mount/strip_clip_10mm.step, and replaces the OpenSCAD clip.
    strip_clip_{base,cap}_10mm.stl are re-exported from it (watertight,
    volumes within 0.1% of the CAD solids, profile face down as before).
    The old parametric clip, its 12 mm STLs and its preview are removed
    from firewatch_mount.scad; the base and lid still export identical to
    their committed STLs. clip.png and clip_3d.png are re-rendered from the
    new design, the old clip is removed from assembly.png, and the docs
    describe the new clip.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
    [firewatch_mount.scad, strip_clip_10mm.step, strip_clip_base_10mm.stl, strip_clip_base_12mm.stl, strip_clip_cap_10mm.stl, strip_clip_cap_12mm.stl]
2026-10-17 Print the strip clip parts chamfered end down
    Both clip STLs are flipped end for end (a 180-degree rotation, not a
    mirror) so the 0.3 mm chamfer sits on the bed and absorbs elephant's
    foot, which would otherwise foul the snap fit. The print notes say so.
    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
    [strip_clip_base_10mm.stl, strip_clip_cap_10mm.stl]
